brkemretr/keychron-q1-he-ks20-firmware/3d_print/Q1-HE_ISO_SPACER_PLATE.3mf

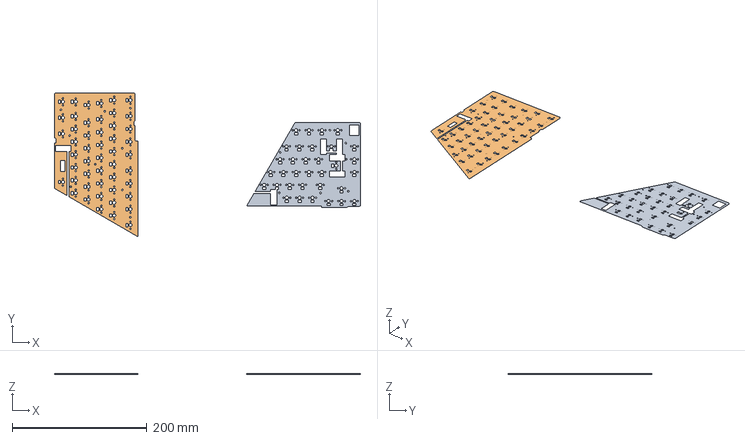
[picture p1: CAD file, 2026-11-05]
3d_print/Q1-HE_ISO_SPACER_PLATE.3mf
453.8 x 213.2 x 1.00 mm
Q1-HE_PCB_PLATE.stl_A
Q1-HE_PCB_PLATE.stl_B
