brkemretr/keychron-q1-he-ks20-firmware/(list of files, cad)

Other CAD files:
3d_print/Q1-HE_ISO_SPACER_PLATE.stl
