brkemretr/keychron-q1-he-ks20-firmware/src/keyboards/keychron/common/analog_matrix/analog_matrix.h

/* Copyright 2024 @ Keychron (https://www.keychron.com)
 *
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
 * You should have received a copy of the GNU General Public License
 * along with this program.  If not, see <http://www.gnu.org/licenses/>.
 */

#pragma once

#include <stdint.h>
#include <stdbool.h>
#include "keycodes.h"
#include "matrix.h"
#include "analog_matrix_eeconfig.h"
#include "analog_matrix_type.h"

#define FULL_TRAVEL_UNIT 40

#ifndef DEFAULT_ACTUATION_POINT
#    define DEFAULT_ACTUATION_POINT 20
#endif

#ifndef DEFAULT_RAPID_TRIGGER_SENSITIVITY
#    define DEFAULT_RAPID_TRIGGER_SENSITIVITY 4
#endif

#ifndef DEFAULT_ZERO_TRAVEL_VALUE
#    define DEFAULT_ZERO_TRAVEL_VALUE 3000
#endif

#ifndef DEFAULT_FULL_RANGE
#    define DEFAULT_FULL_RANGE 900
#endif

#define DEFAULT_FULL_TRAVEL_VALUE (DEFAULT_ZERO_TRAVEL_VALUE - DEFAULT_FULL_RANGE)

#ifndef VALID_ANALOG_RAW_VALUE_MIN
#    define VALID_ANALOG_RAW_VALUE_MIN 100
#endif

#ifndef VALID_ANALOG_RAW_VALUE_MAX
#    define VALID_ANALOG_RAW_VALUE_MAX 4095
#endif

#ifndef REV_POLARITY_ZERO_THRESHOLD
#    define REV_POLARITY_ZERO_THRESHOLD 3450
#endif

#ifndef MIN_FULL_TRAVEL_RANGE
#    define MIN_FULL_TRAVEL_RANGE 400
#endif

#ifndef MIN_REV_FULL_TRAVEL_RANGE
#    define MIN_REV_FULL_TRAVEL_RANGE 20
#endif

#ifndef MIN_REV_BOTTOM_OUT_ADC
#    define MIN_REV_BOTTOM_OUT_ADC 4050
#endif

#ifndef DEFAULT_REV_FULL_RANGE
#    define DEFAULT_REV_FULL_RANGE 120
#endif

#ifndef BOTTOM_JITTER_REV
#    define BOTTOM_JITTER_REV 1
#endif

#ifndef POLYNOMIAL_MIN_X
#    define POLYNOMIAL_MIN_X 1200
#endif

#ifndef STATIC_HYSTERESIS
#    define STATIC_HYSTERESIS 5
#endif

#ifndef RAPID_TRIGGER_TICK
#    define RAPID_TRIGGER_TICK 10
#endif

#ifndef MIN_ACTUATION
#    define MIN_ACTUATION 5
#endif

#ifndef ZERO_TRAVEL_DEAD_ZONE
#    define ZERO_TRAVEL_DEAD_ZONE 20
#endif

#ifndef BOTTOM_DEAD_ZONE
#    define BOTTOM_DEAD_ZONE 38
#endif

#ifndef BOTTOM_JITTER
#    define BOTTOM_JITTER 80
#endif

#define TRAVEL_SCALE 6

#ifndef ANALOG_DEBOUCE_TIME
#    define ANALOG_DEBOUCE_TIME 3
#endif

// Threshold value when the magnet switch is not installed
#ifndef ABNORMAL_ANALOG_RAW_THRESHOLD_VALUE
#    define ABNORMAL_ANALOG_RAW_THRESHOLD_VALUE 3250
#endif

//
#ifndef AUTO_CALIB_FULL_TRAVEL_THRESHOLD_VALUE
#    define AUTO_CALIB_FULL_TRAVEL_THRESHOLD_VALUE (DEFAULT_ZERO_TRAVEL_VALUE - DEFAULT_FULL_RANGE + 100)
#endif

#ifndef AUTO_CALIB_ZERO_TRAVEL_JITTER_VALUE
#    define AUTO_CALIB_ZERO_TRAVEL_JITTER_VALUE 50
#endif

#ifndef AUTO_CALIB_FULL_TRAVEL_JITTER_VALUE
#    define AUTO_CALIB_FULL_TRAVEL_JITTER_VALUE 100
#endif

#ifndef AUTO_CALIB_ZERO_TRAVEL_THRESHOLD_VALUE
#    define AUTO_CALIB_ZERO_TRAVEL_THRESHOLD_VALUE (DEFAULT_FULL_RANGE - AUTO_CALIB_FULL_TRAVEL_JITTER_VALUE)
#endif

#ifndef AUTO_CALIB_VALID_RELASING_TIME
#    define AUTO_CALIB_VALID_RELASING_TIME 1000
#endif

void analog_matrix_init(void);
void analog_matrix_eeconfig_init(void);
bool update_raw_value(uint8_t row, uint8_t col, uint16_t value);
void analog_matrix_save_col_state(uint8_t col);
void analog_matrix_restore_col_state(uint8_t col);
void update_travel_configs(void);
void update_key_config(uint8_t row, uint8_t col);

void analog_matrix_set_mins(uint16_t *min);
void analog_matrix_set_maxs(uint16_t *max);

uint8_t  analog_matrix_get_travel(uint8_t row, uint8_t col);
uint8_t analog_matrix_get_key_mode(uint8_t row, uint8_t col);
bool    analog_matrix_get_key_state(uint8_t row, uint8_t col);
bool    analog_matrix_is_wakeup_pressed(uint8_t row, uint8_t col, uint16_t value);
bool    analog_matrix_lpm_any_key_pressed(void);
bool    analog_matrix_calibrating(void);
matrix_row_t analog_matrix_get_row(uint8_t row);
void    analog_matrix_rx(uint8_t *data, uint8_t length);
void    analog_matrix_task(void);
void    analog_matrix_indicator(void);
