brkemretr/keychron-q1-he-ks20-firmware/src/keyboards/keychron/q1_he/config.h

/* Copyright 2023 @ Keychron (https://www.keychron.com)
 *
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
 * You should have received a copy of the GNU General Public License
 * along with this program.  If not, see <http://www.gnu.org/licenses/>.
 */

#pragma once

#include "analog_matrix_eeconfig.h"

#define I2C_DRIVER I2CD3
#define EXTERNAL_EEPROM_WP_PIN B10
#define I2C1_SCL_PIN A8
#define I2C1_SDA_PIN C9

#define ANALOG_MATRIX_POWER_PIN C13
#define ANALOG_MATRIX_POWER_ENABLE_LEVEL 1
#define ANALOG_MATRIX_WAKEUP_PIN C5

#define ENCODER_SWITCH_PIN A3
#define ENCODER_MATRIX_ROW 0
#define ENCODER_MATROX_COL 14

#ifdef JOYSTICK_ENABLE
#    define JOYSTICK_AXIS_COUNT 6
#    define JOYSTICK_BUTTON_COUNT 16
#endif

#ifdef LK_WIRELESS_ENABLE
/* Hardware configuration */
#    define SPI_SCK_PIN A5
#    define SPI_MISO_PIN A6
#    define SPI_MOSI_PIN A7

#    define P2P4_MODE_SELECT_PIN A10
#    define BT_MODE_SELECT_PIN A9

#    define LKBT51_RESET_PIN C4
#    define LKBT51_INT_INPUT_PIN B1
#    define BLUETOOTH_INT_OUTPUT_PIN A4

#    define USB_POWER_SENSE_PIN B0
#    define USB_POWER_CONNECTED_LEVEL 0

#    define BAT_CHARGING_PIN B13
#    define BAT_CHARGING_LEVEL 0

#    define BT_HOST_DEVICES_COUNT 3

#    if defined(RGB_MATRIX_ENABLE)

#        define LED_DRIVER_SHUTDOWN_PIN B7

#        define BT_HOST_LED_MATRIX_LIST \
            { 15, 16, 17 }

#        define P2P4G_HOST_LED_MATRIX_LIST \
            { 18 }

#        define BAT_LEVEL_LED_LIST \
            { 15, 16, 17, 18, 19, 20, 21, 22, 23, 24 }

/* Backlit disable timeout when keyboard is disconnected(unit: second) */
#        define DISCONNECTED_BACKLIGHT_DISABLE_TIMEOUT 40

/* Backlit disable timeout when keyboard is connected(unit: second) */
#        define CONNECTED_BACKLIGHT_DISABLE_TIMEOUT 600

/* Reinit LED driver on tranport changed */
#        define REINIT_LED_DRIVER 1

#    endif

/* Keep USB connection in blueooth mode */
#    define KEEP_USB_CONNECTION_IN_WIRELESS_MODE

/* Enable bluetooth NKRO */
#    define WIRELESS_NKRO_ENABLE

#endif

/* Force Full N-Key Rollover on USB */
#define FORCE_NKRO

/* Factory test keys */
#define FN_KEY_1 MO(1)
#define FN_KEY_2 MO(3)
#define FN_BL_TRIG_KEY KC_END

#define MATRIX_IO_DELAY 10
