brkemretr/keychron-q1-he-ks20-firmware/src/keyboards/keychron/common/wireless/lpm.c

/* Copyright 2022~2023 @ lokher (https://www.keychron.com)
 *
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
 * You should have received a copy of the GNU General Public License
 * along with this program.  If not, see <http://www.gnu.org/licenses/>.
 */

/******************************************************************************
 *
 *  Filename:      lpm.c
 *
 *  Description:   Contains low power mode implementation
 *
 ******************************************************************************/

#include "quantum.h"
#if defined(PROTOCOL_CHIBIOS)
#    include <usb_main.h>
#endif
#include "debounce.h"
#include "wireless.h"
#include "indicator.h"
#include "lpm.h"
#include "transport.h"
#include "battery.h"
#include "report_buffer.h"
#include "keychron_common.h"

extern matrix_row_t matrix[MATRIX_ROWS];
extern wt_func_t    wireless_transport;

static uint32_t lpm_timer_buffer;
static bool     lpm_time_up = false;
static uint32_t lpm_reset_time = DEFAULT_PROCESS_TIME;
#ifndef OPTICAL_SWITCH
static matrix_row_t empty_matrix[MATRIX_ROWS] = {0};
#endif

pin_t pins_row[MATRIX_ROWS] = MATRIX_ROW_PINS;
pin_t pins_col[MATRIX_COLS] = MATRIX_COL_PINS;

__attribute__((weak)) void select_all_cols(void) {
    for (uint8_t i = 0; i < MATRIX_COLS; i++) {
        setPinOutput(pins_col[i]);
        writePinLow(pins_col[i]);
    }
}

void lpm_init(void) {
#ifdef USB_POWER_SENSE_PIN
#    if (USB_POWER_CONNECTED_LEVEL == 0)
    setPinInputHigh(USB_POWER_SENSE_PIN);
#    else
    setPinInputLow(USB_POWER_SENSE_PIN);
#    endif
#endif
    lpm_timer_reset();
}

inline void lpm_timer_reset(void) {
    lpm_time_up      = false;
    lpm_timer_buffer = timer_read32();
#ifdef ANANLOG_MATRIX
    if (wireless_get_state() == WT_CONNECTED)
        lpm_reset_time = CONNECTED_PROCESS_TIME;
    else
#endif
    lpm_reset_time = DEFAULT_PROCESS_TIME;
}

void lpm_timer_stop(void) {
    lpm_time_up      = false;
    lpm_timer_buffer = 0;
}

static inline bool lpm_any_matrix_action(void) {
#ifdef OPTICAL_SWITCH
    bool any_key = false;
    for (uint8_t i = 0; i < MATRIX_ROWS; i++)
        if (matrix_get_row(i) != 0) {
            any_key = true;
        }
    return any_key;
#else
    return memcmp(matrix, empty_matrix, sizeof(empty_matrix));
#endif
}

__attribute__((weak)) void enter_power_mode_kb(pm_t mode) {}

/* Implement of entering low power mode and wakeup varies per mcu or platform */
__attribute__((weak)) void enter_power_mode(pm_t mode) {
    enter_power_mode_kb(mode);
}

__attribute__((weak)) bool usb_power_connected(void) {
#ifdef USB_POWER_SENSE_PIN
    return readPin(USB_POWER_SENSE_PIN) == USB_POWER_CONNECTED_LEVEL;
#else
    return true;
#endif
}

__attribute__((weak)) bool lpm_is_kb_idle(void) {
    return true;
}

__attribute__((weak)) bool lpm_set(pm_t mode) {
    return false;
}

__attribute__((weak)) void  matrix_lpm(void) {
    /* Enable key matrix wake up */
    for (uint8_t x = 0; x < MATRIX_ROWS; x++) {
        if (pins_row[x] != NO_PIN) {
            palEnableLineEvent(pins_row[x], PAL_EVENT_MODE_BOTH_EDGES);
        }
    }
    select_all_cols();
}

bool pre_enter_low_power_mode(pm_t mode) {
#if defined(KEEP_USB_CONNECTION_IN_WIRELESS_MODE)
    /* Don't enter low power mode if attached to the host */
    if (mode > PM_SLEEP && usb_power_connected()) return false;
#endif

    if (!lpm_set(mode)) return false;

#if defined(KEEP_USB_CONNECTION_IN_WIRELESS_MODE)
    /* Usb unit is actived and running, stop and disconnect first */
    usbStop(&USBD1);
    usbDisconnectBus(&USBD1);

    /* Isolate USB to save power.*/
    // PWR->CR2 &= ~PWR_CR2_USV; /*PWR_CR2_USV is available on STM32L4x2xx and STM32L4x3xx devices only. */
#endif

    battery_stop();

#if (HAL_USE_USB)
    palSetLineMode(A12, PAL_MODE_INPUT_PULLDOWN);
    palSetLineMode(A11, PAL_MODE_INPUT_PULLDOWN);
#endif

#if (HAL_USE_SPI == TRUE)
    palSetLineMode(SPI_SCK_PIN, PAL_MODE_INPUT_PULLDOWN);
    palSetLineMode(SPI_MISO_PIN, PAL_MODE_INPUT_PULLDOWN);
    palSetLineMode(SPI_MOSI_PIN, PAL_MODE_INPUT_PULLDOWN);
#endif

#if (HAL_USE_I2C == TRUE)
    setPinInputHigh(I2C1_SCL_PIN);
    setPinInputHigh(I2C1_SDA_PIN);
#endif

#if defined(DIP_SWITCH_PINS)
#    define NUMBER_OF_DIP_SWITCHES (sizeof(dip_switch_pad) / sizeof(pin_t))
    static pin_t dip_switch_pad[] = DIP_SWITCH_PINS;

    for (uint8_t i = 0; i < NUMBER_OF_DIP_SWITCHES; i++) {
        setPinInputLow(dip_switch_pad[i]);
    }
#endif
#ifdef BAT_CHARGING_PIN
    setPinInputLow(BAT_CHARGING_PIN);
#endif

    palEnableLineEvent(LKBT51_INT_INPUT_PIN, PAL_EVENT_MODE_FALLING_EDGE);
#ifdef USB_POWER_SENSE_PIN
    palEnableLineEvent(USB_POWER_SENSE_PIN, PAL_EVENT_MODE_BOTH_EDGES);
#endif
#ifdef P2P4_MODE_SELECT_PIN
    palEnableLineEvent(P2P4_MODE_SELECT_PIN, PAL_EVENT_MODE_BOTH_EDGES);
#endif
#ifdef BT_MODE_SELECT_PIN
    palEnableLineEvent(BT_MODE_SELECT_PIN, PAL_EVENT_MODE_BOTH_EDGES);
#endif
#ifdef ENCODER_SWITCH_PIN
    palEnableLineEvent(ENCODER_SWITCH_PIN, PAL_EVENT_MODE_FALLING_EDGE);
#endif
    matrix_lpm();

    return true;
}

static inline void lpm_wakeup(void) {
    timer_init();
    palSetLineMode(A11, PAL_STM32_OTYPE_PUSHPULL | PAL_STM32_OSPEED_HIGHEST | PAL_STM32_PUPDR_FLOATING | PAL_MODE_ALTERNATE(10U));
    palSetLineMode(A12, PAL_STM32_OTYPE_PUSHPULL | PAL_STM32_OSPEED_HIGHEST | PAL_STM32_PUPDR_FLOATING | PAL_MODE_ALTERNATE(10U));

#if (HAL_USE_SPI == TRUE)
    palSetLineMode(SPI_SCK_PIN, PAL_MODE_ALTERNATE(5));
    palSetLineMode(SPI_MISO_PIN, PAL_MODE_ALTERNATE(5));
    palSetLineMode(SPI_MOSI_PIN, PAL_MODE_ALTERNATE(5));
#endif

    halInit();

#ifdef ENCODER_ENABLE
    encoder_cb_init();
#endif

    if (wireless_transport.init) wireless_transport.init(true);
    battery_init();

#ifdef ANANLOG_MATRIX
#ifdef ANALOG_MATRIX_WAKEUP_PIN
        palDisableLineEvent(ANALOG_MATRIX_WAKEUP_PIN);
#endif
#else
    /* Disable all wake up pins */
    for (uint8_t x = 0; x < MATRIX_ROWS; x++) {
        if (pins_row[x] != NO_PIN) {
            palDisableLineEvent(pins_row[x]);
        }
    }
#endif

    palDisableLineEvent(LKBT51_INT_INPUT_PIN);
#ifdef P2P4_MODE_SELECT_PIN
    palDisableLineEvent(P2P4_MODE_SELECT_PIN);
#endif
#ifdef BT_MODE_SELECT_PIN
    palDisableLineEvent(BT_MODE_SELECT_PIN);
#endif
#ifdef USB_POWER_SENSE_PIN
    palDisableLineEvent(USB_POWER_SENSE_PIN);

#    if defined(KEEP_USB_CONNECTION_IN_WIRELESS_MODE)
    if (usb_power_connected()) {
        usb_event_queue_init();
        init_usb_driver(&USB_DRIVER);
    }
#    endif

#endif

#if defined(DIP_SWITCH_PINS)
    dip_switch_init();
    dip_switch_read(true);
#endif
#ifdef ENCODER_SWITCH_PIN
    palDisableLineEvent(ENCODER_SWITCH_PIN);
#endif
    /* Call debounce_free() to avoiding memory leak of debounce_counters as debounce_init()
    invoked in matrix_init() alloc new memory to debounce_counters */
    debounce_free();
    matrix_init();
}

void lpm_task(void) {

    if (!lpm_time_up && timer_elapsed32(lpm_timer_buffer) > lpm_reset_time) {
        lpm_time_up      = true;
        lpm_timer_buffer = 0;
    }

    if (usb_power_connected() && USBD1.state  == USB_STOP) {
        usb_event_queue_init();
        init_usb_driver(&USB_DRIVER);
    }

    if ((get_transport() == TRANSPORT_BLUETOOTH || get_transport() == TRANSPORT_P2P4 )
            && lpm_time_up && !indicator_is_running() && lpm_is_kb_idle()) {
#if defined(LED_MATRIX_ENABLE) || defined(RGB_MATRIX_ENABLE)
            if (
#ifdef LED_MATRIX_ENABLE
            !led_matrix_is_enabled() || (led_matrix_is_enabled() && led_matrix_is_driver_shutdown() || (wireless_get_state() == WT_CONNECTED && led_matrix_timeouted())))
#endif
#ifdef RGB_MATRIX_ENABLE
            !rgb_matrix_is_enabled () || (rgb_matrix_is_enabled() && (rgb_matrix_is_driver_shutdown() || (wireless_get_state() == WT_CONNECTED && rgb_matrix_timeouted())))
#endif
            )
#endif
            {
                 if ( !lpm_any_matrix_action() ) {
                    if (pre_enter_low_power_mode(LOW_POWER_MODE)) {
                        enter_power_mode(LOW_POWER_MODE);
                        lpm_wakeup();
                        lpm_timer_reset();
                        report_buffer_init();
                        lpm_set(PM_RUN);

                        if (lpm_woke_from_input()) {
                            if (timer_read32() == 0) {
                                wait_ms(1);
                            }
#ifdef RGB_MATRIX_ENABLE
                            rgb_matrix_disable_time_reset();
                            indicator_eeconfig_reload();
                            if (rgb_matrix_is_enabled()) {
                                indicator_enable();
                            }
#endif
                            if ((get_transport() & TRANSPORT_WIRELESS) &&
                                (wireless_get_state() == WT_SUSPEND || wireless_get_state() == WT_DISCONNECTED)) {
                                wireless_connect();
                            }
                        }
                    }
                 }
            }
        }

}
