brkemretr/keychron-q1-he-ks20-firmware/src/keyboards/keychron/common/wireless/lkbt51.h

/* Copyright 2023 @ Keychron (https://www.keychron.com)
 *
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
 * You should have received a copy of the GNU General Public License
 * along with this program.  If not, see <http://www.gnu.org/licenses/>.
 */

#pragma once

#include "stdint.h"
#include "hal.h"

#ifndef WT_DRIVER
#    define WT_DRIVER SPID1
#endif

// Error checking
#if HAL_USE_SPI == FALSE
#    error "Please enable SPI to use LKBT51"
#endif

#if !STM32_SPI_USE_SPI1 && !STM32_SPI_USE_SPI2 && !STM32_SPI_USE_SPI3
#    error "WT driver activated but no SPI peripheral assigned"
#endif

#define PACKECT_HEADER_LEN 5
#define BDA_LEN 6
#define PACKET_MAX_LEN 64
#define P24G_INDEX 24

enum {
    PAIRING_MODE_DEFAULT = 0x00,
    PAIRING_MODE_JUST_WORK,
    PAIRING_MODE_PASSKEY_ENTRY,
    PAIRING_MODE_LESC_OR_SSP,
    PAIRING_MODE_INVALID,
};

enum {
    BT_MODE_DEFAUL,
    BT_MODE_CLASSIC,
    BT_MODE_LE,
    BT_MODE_INVALID,
};

typedef struct {
    uint8_t     hostIndex;
    uint16_t    timeout;     /* Pairing timeout, valid value range from 30 to 3600 seconds, 0 for default */
    uint8_t     pairingMode; /* 0: default, 1: Just Works, 2: Passkey Entry */
    uint8_t     BRorLE;      /* Only available for dual mode module. Keep 0 for single mode module */
    uint8_t     txPower;     /* Only available for BLE module */
    const char* leName;      /* Only available for BLE module */
} pairing_param_t;

typedef struct {
    uint8_t  type;
    uint16_t full_votage;
    uint16_t empty_voltage;
    uint16_t shutdown_voltage;
} battery_param_t;

typedef struct {
    uint8_t  model_name[11];
    uint8_t  mode;
    uint8_t  bluetooth_version;
    uint8_t  firmware_version[11];
    uint8_t  hardware_version[11];
    uint16_t cmd_set_verson;
} __attribute__((packed)) module_info_t;

typedef struct {
    uint8_t  event_mode; /* Must be 0x02 */
    uint16_t connected_idle_timeout;
    uint16_t pairing_timeout;   /* Range: 30 ~ 3600 second, 0 for default */
    uint8_t  pairing_mode;      /* 0: default, 1: Just Works, 2: Passkey Entry */
    uint16_t reconnect_timeout; /* 0: default, 0xFF: Unlimited time, 2 ~ 254 seconds */
    uint8_t  report_rate;       /* 90 or 133 */
    uint8_t  rsvd1;
    uint8_t  rsvd2;
    uint8_t  vendor_id_source; /* 0: From Bluetooth SIG, 1: From USB-IF */
    uint16_t verndor_id;       /* No effect, the vendor ID is 0x3434 */
    uint16_t product_id;
    /* Below parametes is only available for BLE module  */
    uint16_t le_connection_interval_min;
    uint16_t le_connection_interval_max;
    uint16_t le_connection_interval_timeout;
} __attribute__((packed)) module_param_t;

void lkbt51_init(bool wakeup_from_low_power_mode);
void lkbt51_send_protocol_ver(uint16_t ver);

void lkbt51_send_cmd(uint8_t* payload, uint8_t len, bool ack_enable, bool retry);

void lkbt51_send_keyboard(uint8_t* report);
void lkbt51_send_nkro(uint8_t* report);
void lkbt51_send_consumer(uint16_t report);
void lkbt51_send_system(uint16_t report);
void lkbt51_send_mouse(uint8_t* report);
void lkbt51_send_joysticks(uint8_t* report);
void lkbt51_send_xinput(uint8_t *report);
void lkbt51_send_raw_hid(uint8_t* data, uint8_t len);

void lkbt51_become_discoverable(uint8_t host_idx, void* param);
void lkbt51_connect(uint8_t hostIndex, uint16_t timeout);
void lkbt51_disconnect(void);
void lkbt51_switch_host(uint8_t hostIndex);
void lkbt51_read_state_reg(uint8_t reg, uint8_t len);
void lkbt51_set_xinput_mode(bool enable);

void lkbt51_update_bat_lvl(uint8_t bat_lvl);
void lkbt51_update_bat_state(uint8_t bat_state);

void lkbt51_get_info(module_info_t* info);
void lkbt51_set_param(module_param_t* param);
void lkbt51_get_param(module_param_t* param);
void lkbt51_set_local_name(const char* name);
void lkbt51_get_local_name(void);
void lkbt51_set_ms_swift_pairing_name(const char* name);

void lkbt51_factory_reset(uint8_t p2p4g_clr_msk);
void lkbt51_int_pin_test(bool enable);
void lkbt51_dfu_rx(uint8_t* data, uint8_t length);
void lkbt51_radio_test(uint8_t channel);
void lkbt51_write_customize_data(uint8_t* data, uint8_t len);
bool lkbt51_read_customize_data(uint8_t* data, uint8_t len);

void lkbt51_task(void);
