brkemretr/keychron-q1-he-ks20-firmware/src/keyboards/keychron/common/analog_matrix/analog_matrix_scan.c

/* Copyright 2024 @ Keychron (https://www.keychron.com)
 *
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
 * You should have received a copy of the GNU General Public License
 * along with this program.  If not, see <http://www.gnu.org/licenses/>.
 */

#include "stdint.h"
#include "hal.h"
#include "gpio.h"
#include "quantum.h"
#include "analog_matrix.h"
#include "debounce.h"
#include "lpm.h"

#ifndef HC164_DS
#    define HC164_DS B3
#endif
#ifndef HC164_CP
#    define HC164_CP B5
#endif
#ifndef HC164_MR
#    define HC164_MR D2
#endif

#define ADC_GRP_NUM_CHANNELS MATRIX_ROWS
#define ADC_GRP_BUF_DEPTH 1
#define UNUSED_DEPTH 0

extern matrix_row_t raw_matrix[MATRIX_ROWS];
extern matrix_row_t matrix[MATRIX_ROWS];
extern matrix_row_t game_controller_matrix[MATRIX_ROWS];
extern matrix_row_t okmc_matrix[MATRIX_ROWS];
matrix_row_t analog_raw_matrix[MATRIX_ROWS];
matrix_row_t changed_matrix[MATRIX_ROWS];

pin_t        row_pins[MATRIX_ROWS] = MATRIX_ROW_PINS;
pin_t        col_pins[MATRIX_COLS] = MATRIX_COL_PINS;
matrix_row_t matrix_mask[MATRIX_ROWS];
matrix_row_t virtual_matrix[MATRIX_ROWS] = {0};
static bool matrix_changed;

static adcsample_t samples[ADC_GRP_NUM_CHANNELS * ADC_GRP_BUF_DEPTH];

static void adcerrorcallback(ADCDriver *adcp, adcerror_t err) {
    dprintf("err\r\n");

    (void)adcp;
    (void)err;
}

// clang-format off
ADCConversionGroup adcgrpcfg = {
    FALSE,
    6,
    NULL,
    adcerrorcallback,
    0,                                          /* CR1 */
    ADC_CR2_SWSTART,                            /* CR2 */
    0,                                          /* SMPR1 */
    0,                                          /* SMPR2 */
    0,                                          /* HTR */
    0,                                          /* LTR */
    0,                                          /* SQR1 */
    0,                                          /* SQR2 */
    0                                           /* SQR3 */
};
// clang-format on

uint8_t pinToAdcChn(pin_t pin) {
    switch (pin) {
        case A0:  return ADC_CHANNEL_IN0;
        case A1:  return ADC_CHANNEL_IN1;
        case A2:  return ADC_CHANNEL_IN2;
        case A3:  return ADC_CHANNEL_IN3;
        case A4:  return ADC_CHANNEL_IN4;
        case A5:  return ADC_CHANNEL_IN5;
        case A6:  return ADC_CHANNEL_IN6;
        case A7:  return ADC_CHANNEL_IN7;
        case B0:  return ADC_CHANNEL_IN8;
        case B1:  return ADC_CHANNEL_IN9;
        case C0:  return ADC_CHANNEL_IN10;
        case C1:  return ADC_CHANNEL_IN11;
        case C2:  return ADC_CHANNEL_IN12;
        case C3:  return ADC_CHANNEL_IN13;
        case C4:  return ADC_CHANNEL_IN14;
        case C5:  return ADC_CHANNEL_IN15;
    }

    return 0xFF;
}

static inline void shifter_delay(uint16_t n) {
    while (n-- > 0) {
        asm volatile("nop" ::: "memory");
    }
}

static void HC164_output(uint16_t      data, bool bit_flag) {
    uint8_t n = 50;

    ATOMIC_BLOCK_FORCEON {
        for (uint8_t i = 0; i < 15; i++) {
            if (data & 0x1) {
                writePinHigh(HC164_DS);
            } else {
                writePinLow(HC164_DS);
            }
            shifter_delay(n);
            writePinHigh(HC164_CP);
            shifter_delay(n);
            writePinLow(HC164_CP);
            shifter_delay(n);
            if (bit_flag) {
                break;
            } else {
                data = data >> 1;
            }
        }

    }
}

static bool select_col(uint8_t col) {
    if (col == 0) {
        writePinLow(HC164_MR);
        shifter_delay(20);
        writePinHigh(HC164_MR);
        shifter_delay(20);
        HC164_output(0x01, true);
    }
    return true;
}

static void unselect_col(uint8_t col) {
    HC164_output(0x00, true);
    return;
}

void select_all_cols(void) { }
static void unselect_cols(void) { }

void matrix_read_rows_on_col(uint8_t current_col, matrix_row_t row_shifter) {
    extern matrix_row_t analog_matrix_mask[];

    // Select col
    if (!select_col(current_col)) {
        return;                     // skip NO_PIN col
    }

    wait_us(50);

    uint8_t debouce_times = ANALOG_DEBOUCE_TIME;
    uint8_t row_value     = 0;
    bool    changed       = false;

    do {
        if (debouce_times != ANALOG_DEBOUCE_TIME) {
            wait_us(10);
        }

        adcConvert(&ADCD1, &adcgrpcfg, samples, ADC_GRP_BUF_DEPTH);

        uint8_t row_value_recheck = 0;
        for (uint8_t row_index = 0; row_index < MATRIX_ROWS; row_index++) {
            matrix_row_t row_mask = row_shifter;
            if ((analog_matrix_mask[row_index] & row_mask) == 0) continue;

            update_raw_value(row_index, current_col, samples[row_index]);

            bool pressed = analog_matrix_get_key_state(row_index, current_col);
            if (pressed) {
                if ((analog_raw_matrix[row_index] & row_mask) == 0) {
                    changed = true;
                }
                if (debouce_times == ANALOG_DEBOUCE_TIME) {
                    row_value |= (0x01 << row_index);
                } else {
                    row_value_recheck |= (0x01 << row_index);
                }
            } else if (analog_raw_matrix[row_index] & row_mask) {
                changed = true;
            }
        }

        if (debouce_times != ANALOG_DEBOUCE_TIME && row_value != row_value_recheck) {
            changed = false;
        }
    } while (--debouce_times && changed);

    if (changed) {
        matrix_changed = true;
        for (uint8_t row_index = 0; row_index < MATRIX_ROWS; row_index++) {
            if (row_value & (0x01 << row_index)) {
                if ((analog_raw_matrix[row_index] & row_shifter) == 0) {
                    changed_matrix[row_index] |= row_shifter;
                }
                analog_raw_matrix[row_index] |= row_shifter;
            } else {
                if (analog_raw_matrix[row_index] & row_shifter) {
                    changed_matrix[row_index] |= row_shifter;
                }
                analog_raw_matrix[row_index] &= ~row_shifter;
            }
        }
    }

    // Unselect col
    unselect_col(current_col);
}

void matrix_init_custom(void) {
    uint32_t smpr[2] = {0, 0};
    uint32_t sqr[3] = {0, 0, 0};
    uint8_t chn;
    uint8_t chn_cnt = 0;

#ifdef ANALOG_MATRIX_POWER_PIN
   setPinOutput(ANALOG_MATRIX_POWER_PIN);
   writePin(ANALOG_MATRIX_POWER_PIN, ANALOG_MATRIX_POWER_ENABLE_LEVEL);
#endif
#ifdef ANALOG_MATRIX_WAKEUP_PIN
    setPinInputHigh(ANALOG_MATRIX_WAKEUP_PIN);
#endif
#ifdef ENCODER_SWITCH_PIN
    setPinInputHigh(ENCODER_SWITCH_PIN);
#endif

    // Init shift register control pins
    setPinOutput(HC164_DS);
    setPinOutput(HC164_CP);
    setPinOutput(HC164_MR);
    writePinLow(HC164_MR);

    for (uint8_t x = 0; x < MATRIX_ROWS; x++) {
        if (row_pins[x] != NO_PIN) {
            palSetLineMode(row_pins[x], PAL_MODE_INPUT_ANALOG);
            palWriteLine(row_pins[x], 0);
        }

        chn = pinToAdcChn(row_pins[x]);
        if (chn < 0xFF) {
            if (chn > 9 )
                smpr[0] |= ADC_SAMPLE_56 << ((chn-10) * 3);
            else
                smpr[1] |= ADC_SAMPLE_56 << (chn * 3);

            sqr[chn_cnt/6] |= chn << ((chn_cnt % 6) * 5);
            chn_cnt++;
        }
    }

    adcgrpcfg.smpr1 = smpr[0];
    adcgrpcfg.smpr2 = smpr[1];

    adcgrpcfg.sqr3 = sqr[0];
    adcgrpcfg.sqr2 = sqr[1];
    adcgrpcfg.sqr1 = sqr[2];

    unselect_cols();
    adcStart(&ADCD1, NULL);

    // Refer to STM32 AN4073 Option 2
    SYSCFG->PMC |= SYSCFG_PMC_ADC1DC2;

    // Value of initial ADC seems abnormal, scan to skip/drop i
    for (uint8_t i=0; i<5; i++)
        for (uint8_t current_col = 0; current_col < MATRIX_COLS; current_col++) {
            matrix_read_rows_on_col(current_col, 0);
        }

    for (uint8_t i = 0; i < MATRIX_ROWS; i++) {
         analog_raw_matrix[i] = 0;
         changed_matrix[i] = 0;
    }

    analog_matrix_init();
}

bool matrix_scan_custom(matrix_row_t current_matrix[]) {
    matrix_row_t last_raw_matrix[MATRIX_ROWS];

    memcpy(last_raw_matrix, raw_matrix, sizeof(raw_matrix));
    memcpy(virtual_matrix, matrix, sizeof(matrix));
    memset(changed_matrix, 0, sizeof(changed_matrix));
    matrix_changed = false;

    // Set col, read rows
    matrix_row_t row_shifter = MATRIX_ROW_SHIFTER;
    for (uint8_t current_col = 0; current_col < MATRIX_COLS; current_col++, row_shifter <<= 1) {
        matrix_read_rows_on_col(current_col, row_shifter);
    }

    analog_matrix_task();
    extern matrix_row_t analog_matrix_mask[];
    for (uint8_t row = 0; row < MATRIX_ROWS; row++) {
       raw_matrix[row] &= analog_matrix_mask[row];
    }

#if defined(ENCODER_MATRIX_ROW) && defined(ENCODER_MATRIX_ROW)
    if (readPin(ENCODER_SWITCH_PIN) == 0) {
        if ((raw_matrix[ENCODER_MATRIX_ROW] & (1 << ENCODER_MATROX_COL)) == 0) {
            matrix_changed = true;
            raw_matrix[ENCODER_MATRIX_ROW] |= (1 << ENCODER_MATROX_COL);
        }
    } else {
        if ((raw_matrix[ENCODER_MATRIX_ROW] & (1 << ENCODER_MATROX_COL))) {
            matrix_changed = true;
            raw_matrix[ENCODER_MATRIX_ROW] &= ~(1 << ENCODER_MATROX_COL);
        }
    }
#endif

    for (uint8_t row = 0; row < MATRIX_ROWS; row++) {
       virtual_matrix[row] |= (game_controller_matrix[row] | okmc_matrix[row]);
    }

    bool changed = memcmp(raw_matrix, last_raw_matrix, sizeof(last_raw_matrix)) != 0;
    //changed = debounce(raw_matrix, matrix, MATRIX_ROWS, changed);

    matrix_scan_kb();

    return matrix_changed | changed;
}

void  matrix_lpm(void) {
    adcStop(&ADCD1);

#ifdef HC164_DS
    setPinInputLow(HC164_DS);
#endif
#ifdef HC164_CP
    setPinInputLow(HC164_CP);
#endif
#ifdef HC164_MR
    setPinInputLow(HC164_MR);
#endif

#ifdef ANALOG_MATRIX_POWER_PIN
       writePin(ANALOG_MATRIX_POWER_PIN, !ANALOG_MATRIX_POWER_ENABLE_LEVEL);
#endif

#ifdef ANALOG_MATRIX_WAKEUP_PIN
    palEnableLineEvent(ANALOG_MATRIX_WAKEUP_PIN, PAL_EVENT_MODE_FALLING_EDGE);
#endif

    // Set all row to input low
    pin_t pins_row[MATRIX_ROWS] = MATRIX_ROW_PINS;
    for (uint8_t x = 0; x < MATRIX_ROWS; x++) {
        if (pins_row[x] != NO_PIN) {
            setPinInputLow(pins_row[x]);
        }
    }

}

bool analog_matrix_lpm_any_key_pressed(void) {
    extern matrix_row_t analog_matrix_mask[];
    bool any_pressed = false;

#ifdef ANALOG_MATRIX_WAKEUP_PIN
    EXTI->IMR &= ~(1U << PAL_PAD(ANALOG_MATRIX_WAKEUP_PIN));
#endif

#ifdef ANALOG_MATRIX_POWER_PIN
    setPinOutput(ANALOG_MATRIX_POWER_PIN);
    writePin(ANALOG_MATRIX_POWER_PIN, ANALOG_MATRIX_POWER_ENABLE_LEVEL);
#endif

    setPinOutput(HC164_DS);
    setPinOutput(HC164_CP);
    setPinOutput(HC164_MR);
    writePinLow(HC164_MR);

    for (uint8_t x = 0; x < MATRIX_ROWS; x++) {
        if (row_pins[x] != NO_PIN) {
            palSetLineMode(row_pins[x], PAL_MODE_INPUT_ANALOG);
            palWriteLine(row_pins[x], 0);
        }
    }

    adcStart(&ADCD1, NULL);
    SYSCFG->PMC |= SYSCFG_PMC_ADC1DC2;

    // Warm up Hall sensors and ADC after power-on (3 passes across columns)
    for (uint8_t i = 0; i < 3; i++) {
        for (uint8_t current_col = 0; current_col < MATRIX_COLS; current_col++) {
            select_col(current_col);
            shifter_delay(600);
            adcConvert(&ADCD1, &adcgrpcfg, samples, ADC_GRP_BUF_DEPTH);
            unselect_col(current_col);
        }
    }

    // Check if any active key in the matrix is pressed past wakeup threshold
    for (uint8_t current_col = 0; current_col < MATRIX_COLS; current_col++) {
        select_col(current_col);
        shifter_delay(600);
        adcConvert(&ADCD1, &adcgrpcfg, samples, ADC_GRP_BUF_DEPTH);

        for (uint8_t row_index = 0; row_index < MATRIX_ROWS; row_index++) {
            if ((analog_matrix_mask[row_index] & (1U << current_col)) == 0) continue;
            if (analog_matrix_is_wakeup_pressed(row_index, current_col, samples[row_index])) {
                shifter_delay(200);
                adcConvert(&ADCD1, &adcgrpcfg, samples, ADC_GRP_BUF_DEPTH);
                if (analog_matrix_is_wakeup_pressed(row_index, current_col, samples[row_index])) {
                    any_pressed = true;
                    break;
                }
            }
        }
        unselect_col(current_col);
        if (any_pressed) break;
    }

    adcStop(&ADCD1);

#ifdef HC164_DS
    setPinInputLow(HC164_DS);
#endif
#ifdef HC164_CP
    setPinInputLow(HC164_CP);
#endif
#ifdef HC164_MR
    setPinInputLow(HC164_MR);
#endif

#ifdef ANALOG_MATRIX_POWER_PIN
    writePin(ANALOG_MATRIX_POWER_PIN, !ANALOG_MATRIX_POWER_ENABLE_LEVEL);
#endif

    for (uint8_t x = 0; x < MATRIX_ROWS; x++) {
        if (row_pins[x] != NO_PIN) {
            setPinInputLow(row_pins[x]);
        }
    }

#ifdef ANALOG_MATRIX_WAKEUP_PIN
    shifter_delay(1000);
    EXTI->PR = (1U << PAL_PAD(ANALOG_MATRIX_WAKEUP_PIN));
    EXTI->IMR |= (1U << PAL_PAD(ANALOG_MATRIX_WAKEUP_PIN));
#endif

    return any_pressed;
}
