brkemretr/keychron-q1-he-ks20-firmware/(commit log)

2026-10-29 v1.3.1-ks20: restore Keychron auto-calibration state machine, Schmitt deadband (<3) and stock 3-pass debounce; remove timer-based upward re-zero
2026-10-29 docs: clearly document hardware limits, 3.5mm stroke, op-amp saturation and recommended actuation range
2026-10-30 docs: document 1.0mm standoff spacer telemetry, 2.2x resolution gain and saturation reality
2026-11-05 fix(wireless): resolve PM_STOP deep sleep wake-up for KS-20 switches and add 3D-printable 1.0mm acoustic spacer pads
    [Q1-HE_PCB_PLATE.stl, Q1-HE_SPACER_PLATE.3mf]
2026-11-05 docs(3d_print): rename 3D spacer pad files to Q1-HE_ISO_SPACER_PLATE (.stl & .3mf) and note ISO layout
    [Q1-HE_ISO_SPACER_PLATE.3mf, Q1-HE_ISO_SPACER_PLATE.stl]
2026-11-05 v1.3.4-ks20: Add Keychron Link (2.4GHz) wireless Raw HID support, fix LKBT51 SPI stack buffer overflows & Launcher lockup
    [analog_matrix.c, lkbt51.c, lkbt51.h, profile.c, wireless.c, wireless.h, wireless_event_type.h]
2026-11-05 Fix dangling stack pointer in LKBT51_CMD_RAW_HID_RX (use static raw_hid_data[64])
    [lkbt51.c]
