brkemretr/keychron-q1-he-ks20-firmware/(notices)

Notices in the files:
src/keyboards/keychron/q1_he/config.h:
This program is free software: you can redistribute it and/or modify
it under the terms of the GNU General Public License as published by
the Free Software Foundation, either version 2 of the License, or
(at your option) any later version.
README.md:
License: GPL v2
